haeun2525/nu87-desk-penguin/case/stl/2_black_head.stl

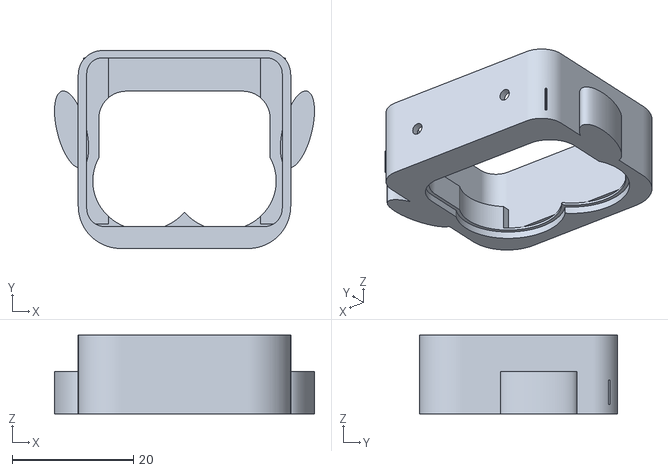
[picture p3: CAD file, 2026-10-28]
case/stl/2_black_head.stl
42.8 x 32.6 x 13.0
