haeun2525/nu87-desk-penguin/case/stl/touch/2_black_back_touch.stl

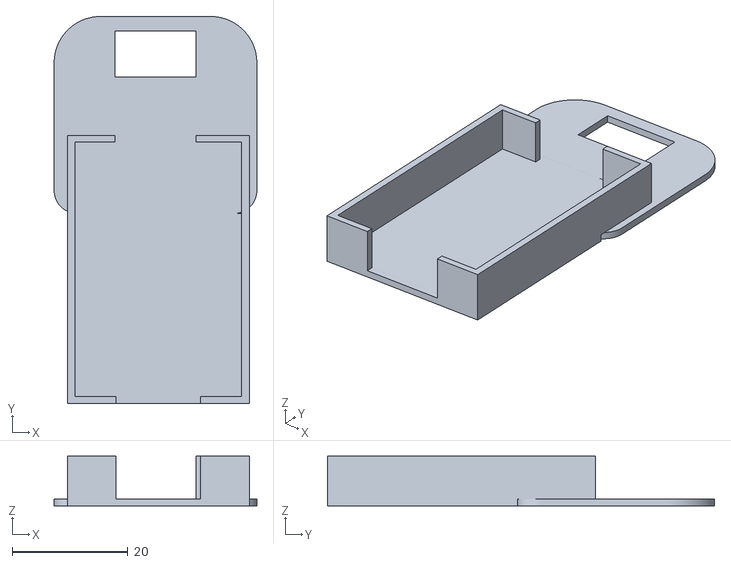
[picture p4: CAD file, 2026-10-28]
case/stl/touch/2_black_back_touch.stl
35.0 x 66.8 x 8.60
