haeun2525/nu87-desk-penguin/case/stl/1_white_face.stl

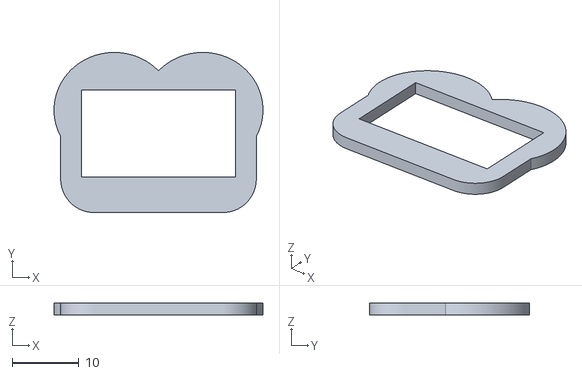
[picture p5: CAD file, 2026-10-28]
case/stl/1_white_face.stl
31.2 x 23.9 x 1.80
