haeun2525/nu87-desk-penguin/case/stl/touch/2_black_head_touch.stl

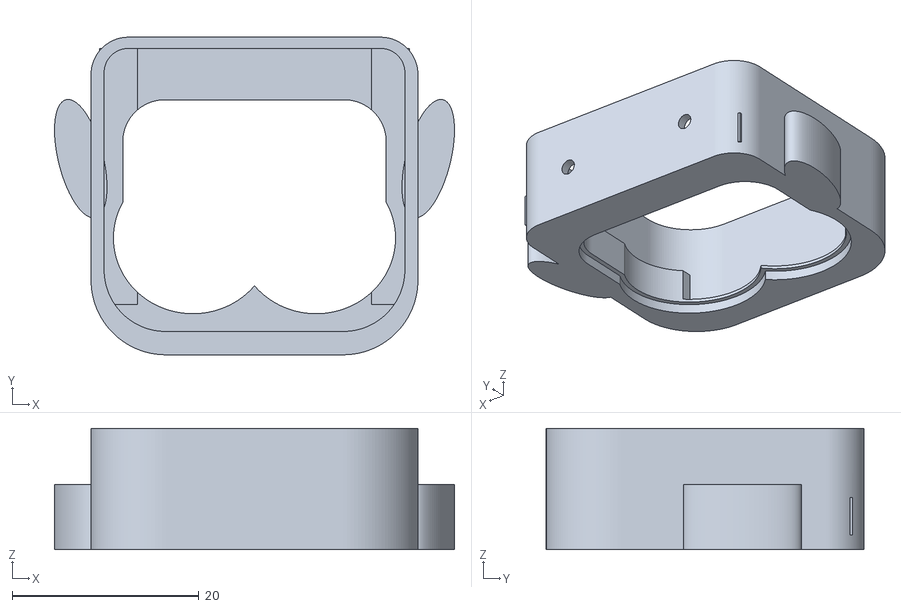
[picture p6: CAD file, 2026-10-28]
case/stl/touch/2_black_head_touch.stl
42.8 x 34.0 x 13.0
