haeun2525/nu87-desk-penguin/case/stl/1_white_cover.stl

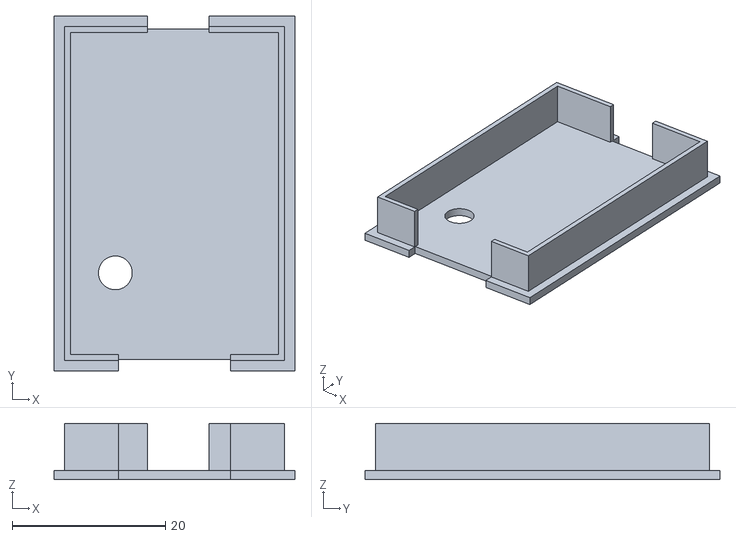
[picture p7: CAD file, 2026-10-28]
case/stl/1_white_cover.stl
31.4 x 46.3 x 7.35
