haeun2525/nu87-desk-penguin/case/stl/2_black_back.stl

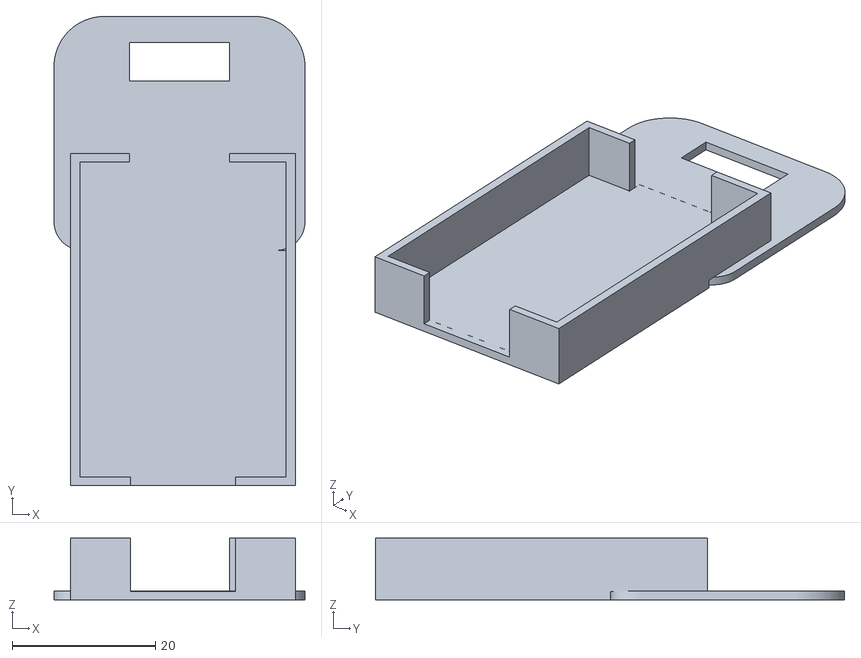
[picture p8: CAD file, 2026-10-28]
case/stl/2_black_back.stl
35.0 x 65.4 x 8.60
