haeun2525/nu87-desk-penguin/case/stl/3_orange_legs.stl

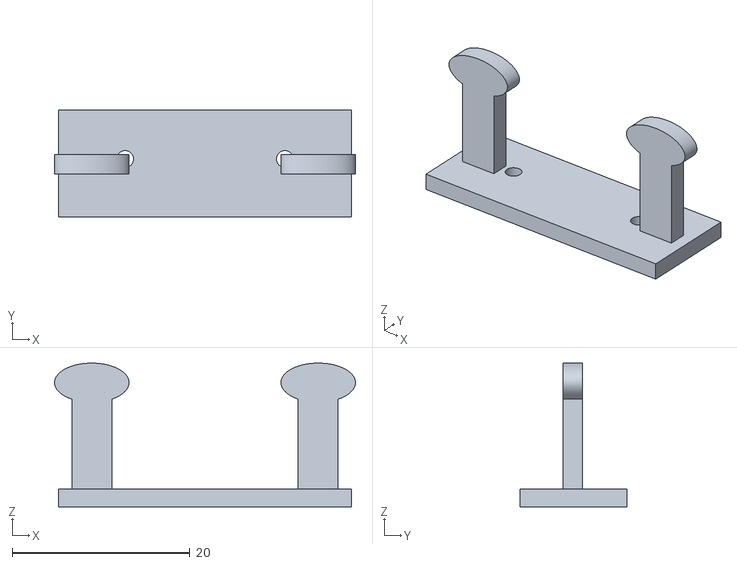
[picture p9: CAD file, 2026-10-28]
case/stl/3_orange_legs.stl
33.9 x 12.0 x 16.2
