haeun2525/nu87-desk-penguin/(commit log)

2026-10-28 NU87 데스크 펭귄: 펌웨어, 맥 알림 연결 프로그램, 케이스
    [1_white_cover.stl, 1_white_face.stl, 2_black_back.stl, 2_black_back_touch.stl, 2_black_head.stl, 2_black_head_touch.stl, 3_orange_legs.stl]
2026-10-30 날씨 비 확률은 지금부터 오늘 끝까지만 본다
2026-10-30 자동 실행은 Command Line Tools 의 Python.app 으로 — 전체 디스크 접근 권한이 먹히게
2026-10-30 카톡 창·지메일 탭을 보면 보드의 안 읽음 표시를 지운다
2026-10-30 글꼴에 없는 글자 정리 — 굵은 수학 글자는 보통 글자로, 이모지는 빼기. 노래 제목은 2줄
2026-10-30 같은 사람이 1분 안에 또 보내면 놀란 얼굴 없이 내용만 이어서
2026-10-30 촬영용 실제 알림 다시 띄우기 (alerts.sh 이름/내용)
